ESD510-Slamsugerbanden/PublicAppendix/README.md

# PublicAppendix
Public Appendix for the 5th semester project. Consisting of test data.
