ESD510-Slamsugerbanden/PublicAppendix/Inventor/Sentry3/Motor.png

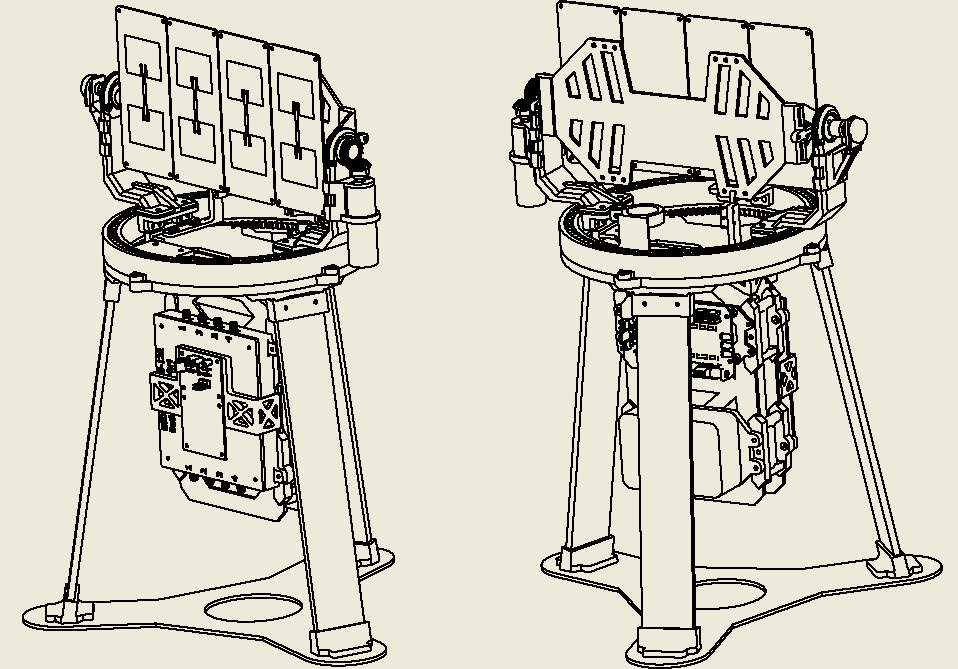
Inventor/Sentry3/Motor.png
