ESD510-Slamsugerbanden/PublicAppendix/Hardware/Komponenter/ADG904BCPZ/3D/ADG904BCPZ.stp

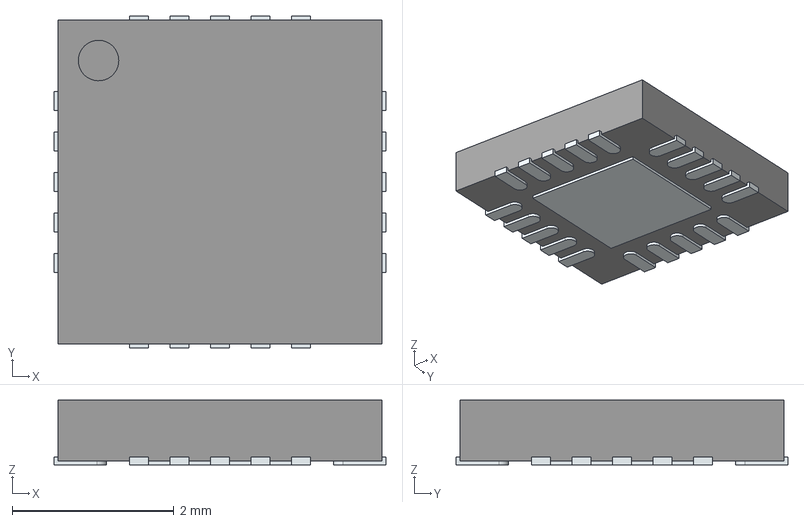
[picture p2: CAD file, 2025-12-19]
Hardware/Komponenter/ADG904BCPZ/3D/ADG904BCPZ.stp
4.10 x 4.10 x 0.8 mm
ThermalPin
PinsArrayLR
PinsArrayTB
