ESD510-Slamsugerbanden/PublicAppendix/Hardware/Komponenter/RFX2401C/3D/RFX2401C.stp

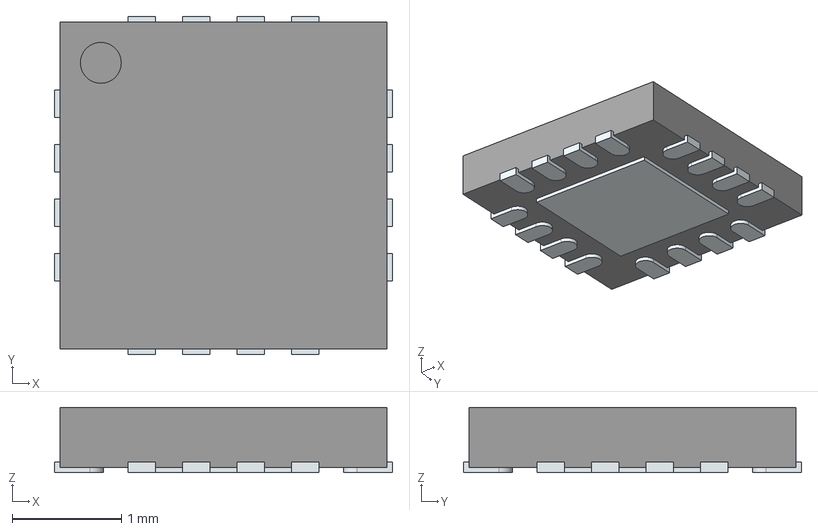
[picture p3: CAD file, 2025-12-19]
Hardware/Komponenter/RFX2401C/3D/RFX2401C.stp
3.10 x 3.10 x 0.6 mm
ThermalPin
PinsArrayLR
PinsArrayTB
