ESD510-Slamsugerbanden/PublicAppendix/Inventor/Antenna holder.stl

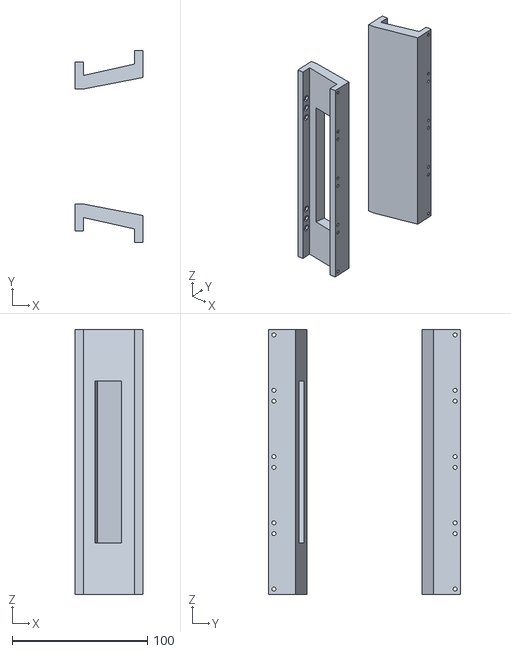
[picture p4: CAD file, 2025-12-19]
Inventor/Antenna holder.stl
50.0 x 142.0 x 196.0
