ESD510-Slamsugerbanden/PublicAppendix/Inventor/Butler_matrix/Case.stl

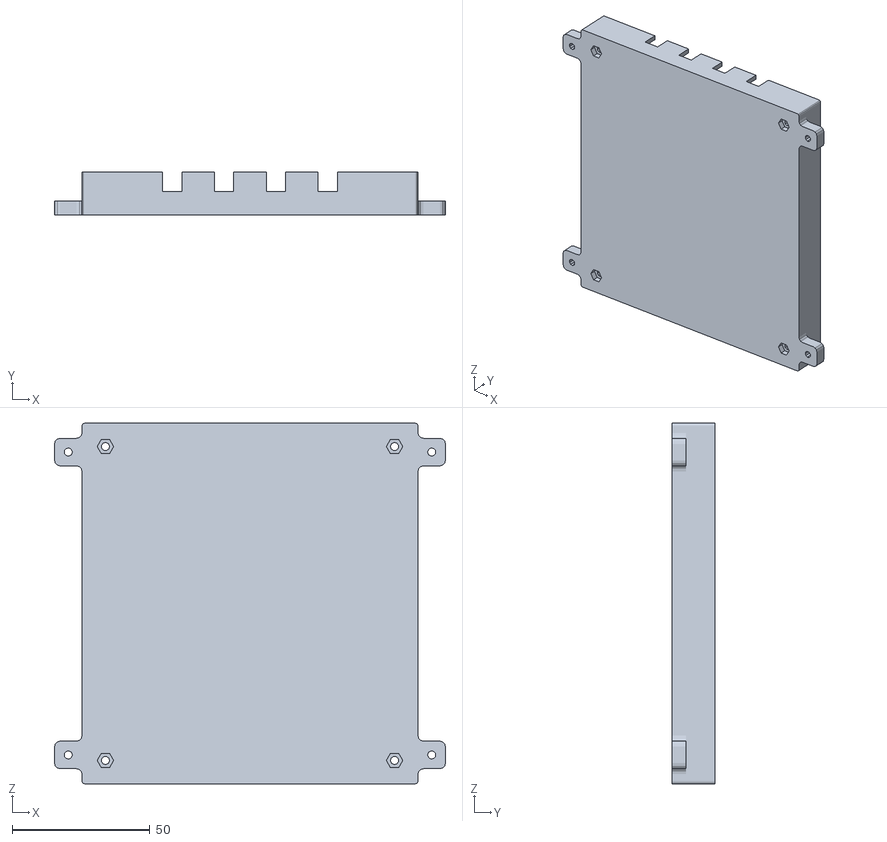
[picture p5: CAD file, 2025-12-19]
Inventor/Butler_matrix/Case.stl
142.0 x 15.5 x 131.0
