ESD510-Slamsugerbanden/PublicAppendix/Inventor/Butler_matrix/Butler_matrix.step

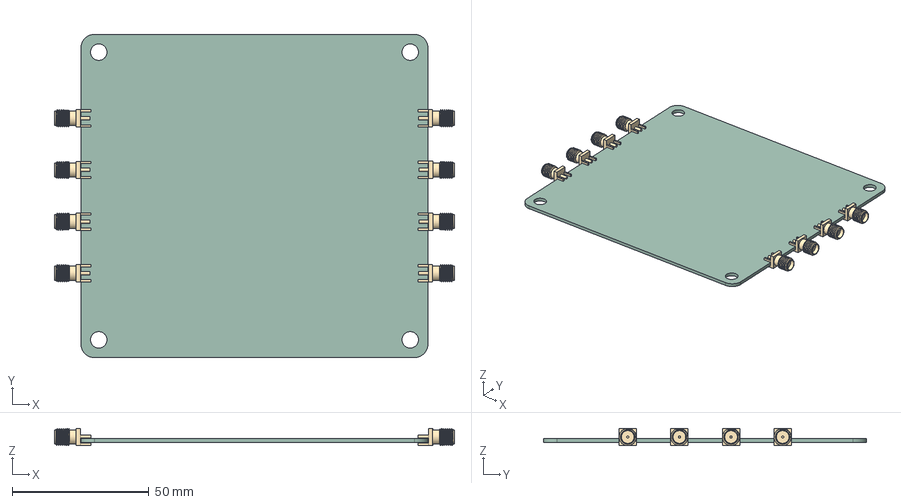
[picture p6: CAD file, 2025-12-19]
Inventor/Butler_matrix/Butler_matrix.step
146.0 x 118.0 x 6.35 mm
SMA_Samtec_SMA-J-P-H-ST-EM1_EdgeMount x 8
Butler_matrix_PCB
