ESD510-Slamsugerbanden/PublicAppendix/Inventor/Mux_adapter.step

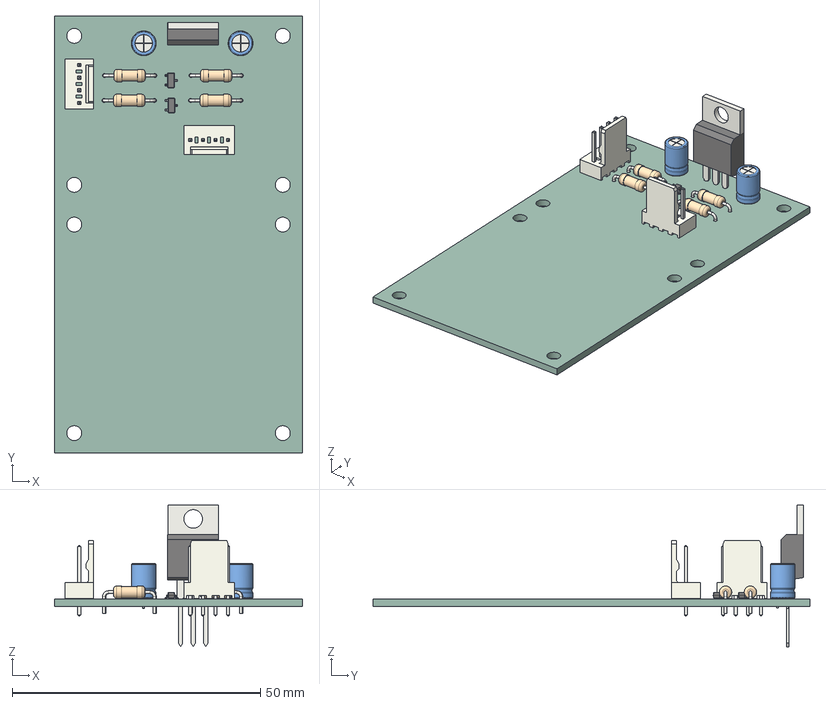
[picture p7: CAD file, 2025-12-19]
Inventor/Mux_adapter.step
50.0 x 88.0 x 28.5 mm
C_Radial_D5.0mm_H7.0mm_P2.00mm x 2
R_Axial_DIN0207_L6.3mm_D2.5mm_P10.16mm_Horizontal x 4
TO-220-3_Vertical
Molex_KK-254_AE-6410-04A_1x04_P2.54mm_Vertical x 2
SOT-23 x 2
Mux_adapter_PCB
