ESD510-Slamsugerbanden/PublicAppendix/Inventor/Sentry3/Pot_adapter.stl

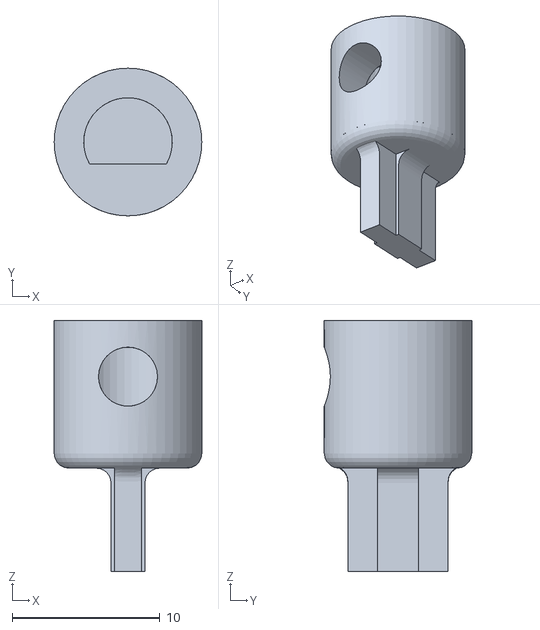
[picture p8: CAD file, 2025-12-19]
Inventor/Sentry3/Pot_adapter.stl
10.0 x 10.0 x 17.0
