ESD510-Slamsugerbanden/PublicAppendix/Inventor/Motor_controller_P5.step

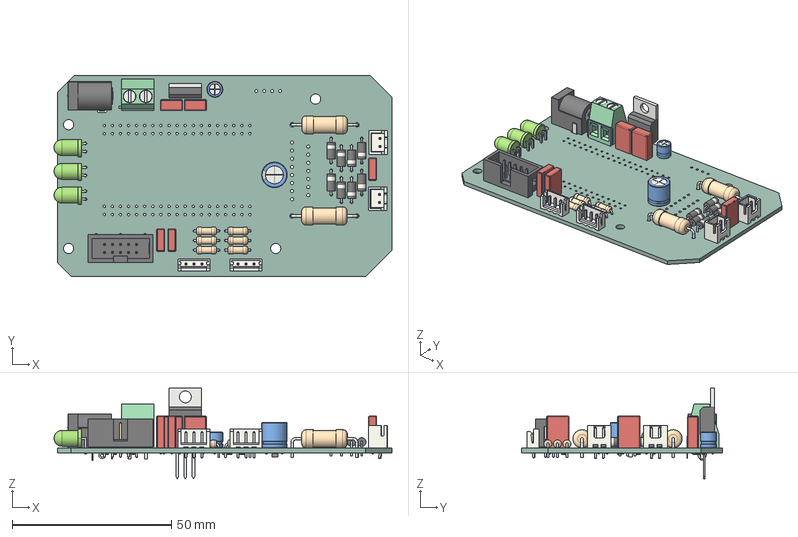
[picture p9: CAD file, 2025-12-19]
Inventor/Motor_controller_P5.step
106.1 x 63.0 x 28.5 mm
CP_Radial_D8.0mm_P5.00mm
JST_EH_B3B-EH-A_1x03_P2.50mm_Vertical x 2
C_Rect_L7.0mm_W2.5mm_P5.00mm x 3
R_Axial_DIN0614_L14.3mm_D5.7mm_P20.32mm_Horizontal x 2
R_Axial_DIN0207_L6.3mm_D2.5mm_P7.62mm_Horizontal x 6
D_A-405_P7.62mm_Horizontal x 8
CP_Radial_D5.0mm_P2.50mm
BarrelJack_Horizontal
TerminalBlock_Phoenix_MKDS-1,5-2-5.08_1x02_P5.08mm_Horizontal
IDC-Header_2x05_P2.54mm_Vertical
C_Rect_L7.0mm_W3.5mm_P5.00mm x 2
LED_D5.0mm_Horizontal_O1.27mm_Z3.0mm x 3
TO-220-3_Vertical
JST_XH_B2B-XH-A_1x02_P2.50mm_Vertical x 2
R_0603_1608Metric x 8
R_0805_2012Metric x 3
C_0805_2012Metric
Motor_controller_P5_PCB
