ESD510-Slamsugerbanden/PublicAppendix/(list of files, cad)

Other CAD files:
Inventor/Sentry3/Motor.dwg
Inventor/TestPlatform/Lasercutplade.dwg
Inventor/Backplane.dwg
Inventor/switch cover.dwg
Inventor/Cover_acryl.dwg
Inventor/Sentry3/OldVersions/Motor.0002.dwg
Hardware/Komponenter/ADG904BCPZ/Allegro/qfn50p400x400x80-21n-d.psm
Hardware/Komponenter/ADG904BCPZ/DEHDL/adg904bcpz/chips/chips.prt
Hardware/Komponenter/RFX2401C/Allegro/qfn50p300x300x60-17n-d.psm
Hardware/Komponenter/RFX2401C/DEHDL/rfx2401c/chips/chips.prt
Inventor/Antenna holder.ipt
Inventor/Backplane.ipt
Inventor/Butler_matrix/Butler_assembly.iam
Inventor/Butler_matrix/Butler_matrix/Butler_matrix.ipt
Inventor/Butler_matrix/Case.ipt
Inventor/Butler_matrix/Cover_acryl.ipt
Inventor/Butler_matrix/OldVersions/Butler_assembly.0004.iam
Inventor/Butler_matrix/OldVersions/Case.0007.ipt
Inventor/Butler_matrix/OldVersions/Cover_acryl.0005.ipt
Inventor/Mux_adapter/Mux_adapter/C_Radial_D5.0mm_H7.0mm_P2.00mm.ipt
Inventor/Mux_adapter/Mux_adapter/Molex_KK-254_AE-6410-04A_1x04_P2.54mm_Vertical.ipt
Inventor/Mux_adapter/Mux_adapter/Mux_adapter.iam
Inventor/Mux_adapter/Mux_adapter/Mux_adapter_PCB.ipt
Inventor/Mux_adapter/Mux_adapter/R_Axial_DIN0207_L6.3mm_D2.5mm_P10.16mm_Horizontal.ipt
Inventor/Mux_adapter/Mux_adapter/SOT-23.ipt
Inventor/Mux_adapter/Mux_adapter/TO-220-3_Vertical.ipt
Inventor/Mux_pcb.iam
Inventor/OldVersions/Antenna holder.0001.ipt
Inventor/OldVersions/Backplane.0003.ipt
Inventor/Sentry3/Adapter.ipt
Inventor/Sentry3/Angle_motor.ipt
Inventor/Sentry3/Balls.ipt
Inventor/Sentry3/Bearing.ipt
Inventor/Sentry3/Bund.ipt
Inventor/Sentry3/Center_lysekrone.ipt
Inventor/Sentry3/Elevation_mount.ipt
Inventor/Sentry3/Gear_2.ipt
Inventor/Sentry3/Homing_switch_holder.ipt
Inventor/Sentry3/Inner gear.ipt
Inventor/Sentry3/Krone_interface.ipt
Inventor/Sentry3/LEG.ipt
Inventor/Sentry3/Lazercut_base.ipt
Inventor/Sentry3/Lazercutlink.ipt
Inventor/Sentry3/Lock buttom.ipt
Inventor/Sentry3/Lysekrone_adapter.ipt
Inventor/Sentry3/Motor.iam
Inventor/Sentry3/Motor/Design Accelerator/Bevel Gear11.ipt
Inventor/Sentry3/Motor/Design Accelerator/Bevel Gear21.ipt
Inventor/Sentry3/Motor/Design Accelerator/Bevel Gears1.iam
Inventor/Sentry3/Motor/Design Accelerator/OldVersions/Bevel Gear11.0009.ipt
Inventor/Sentry3/Motor/Design Accelerator/OldVersions/Bevel Gear21.0004.ipt
Inventor/Sentry3/Motor/Design Accelerator/OldVersions/Bevel Gears1.0005.iam
Inventor/Sentry3/Motor/Design Accelerator/Spur Gears1.iam
Inventor/Sentry3/Motor/Design Accelerator/Worm Gear1.ipt
Inventor/Sentry3/Motor/Design Accelerator/Worm Gears1.iam
Inventor/Sentry3/Motor/Design Accelerator/Worm1.ipt
Inventor/Sentry3/Motor_driver.ipt
Inventor/Sentry3/Motor_elevation.ipt
Inventor/Sentry3/Motordriver_Adapter.ipt
Inventor/Sentry3/Mux_holder.ipt
Inventor/Sentry3/Mux_switch_holder.ipt
Inventor/Sentry3/OldVersions/Angle_motor.0001.ipt
Inventor/Sentry3/OldVersions/Bearing.0013.ipt
Inventor/Sentry3/OldVersions/Bund.0001.ipt
Inventor/Sentry3/OldVersions/Center_lysekrone.0002.ipt
Inventor/Sentry3/OldVersions/Elevation_mount.0001.ipt
Inventor/Sentry3/OldVersions/Homing_switch_holder.0001.ipt
Inventor/Sentry3/OldVersions/Inner gear.0006.ipt
Inventor/Sentry3/OldVersions/Krone_interface.0002.ipt
Inventor/Sentry3/OldVersions/LEG.0002.ipt
Inventor/Sentry3/OldVersions/Lazercut_base.0004.ipt
Inventor/Sentry3/OldVersions/Lazercutlink.0005.ipt
Inventor/Sentry3/OldVersions/Lock buttom.0005.ipt
Inventor/Sentry3/OldVersions/Motor.0057.iam
Inventor/Sentry3/OldVersions/Motor_driver.0002.ipt
Inventor/Sentry3/OldVersions/Mux_switch_holder.0003.ipt
Inventor/Sentry3/OldVersions/Outer_gear.0010.ipt
Inventor/Sentry3/OldVersions/Pi_holder.0001.ipt
Inventor/Sentry3/OldVersions/PotMeter.0004.ipt
Inventor/Sentry3/OldVersions/Pot_adapter.0004.ipt
Inventor/Sentry3/OldVersions/Pot_holder.0001.ipt
Inventor/Sentry3/OldVersions/Potmeter_elemount.0003.ipt
Inventor/Sentry3/OldVersions/RPI.0002.ipt
Inventor/Sentry3/OldVersions/Shelf1.0001.ipt
Inventor/Sentry3/OldVersions/Shelf2.0001.ipt
Inventor/Sentry3/OldVersions/Venstre arm.0004.ipt
Inventor/Sentry3/OldVersions/Venstre_bearing_lock.0002.ipt
Inventor/Sentry3/OldVersions/Venstre_roller_gear.0001.ipt
Inventor/Sentry3/OldVersions/Venstre_rotator.0004.ipt
Inventor/Sentry3/OldVersions/switch.0001.ipt
Inventor/Sentry3/Outer_gear.ipt
Inventor/Sentry3/Phased_array.ipt
Inventor/Sentry3/Pi_holder.ipt
Inventor/Sentry3/PotMeter.ipt
Inventor/Sentry3/Pot_adapter.ipt
Inventor/Sentry3/Pot_holder.ipt
Inventor/Sentry3/Potmeter_elemount.ipt
Inventor/Sentry3/RPI.ipt
Inventor/Sentry3/RPI_Motordriver_mount.ipt
Inventor/Sentry3/Shelf1.ipt
Inventor/Sentry3/Shelf2.ipt
Inventor/Sentry3/Spacer_1.ipt
Inventor/Sentry3/Spacer_1_MIR.ipt
Inventor/Sentry3/Spacer_1_MIR1.ipt
Inventor/Sentry3/Spacer_1_MIR_MIR.ipt
Inventor/Sentry3/USRPB210.ipt
Inventor/Sentry3/Venstre arm.ipt
Inventor/Sentry3/Venstre_bearing_lock.ipt
Inventor/Sentry3/Venstre_roller_gear.ipt
Inventor/Sentry3/Venstre_rotator.ipt
Inventor/Sentry3/switch.ipt
Inventor/TestPlatform/Base stand.ipt
Inventor/TestPlatform/Lasercutplade.ipt
Inventor/TestPlatform/Motor.ipt
Inventor/TestPlatform/OldVersions/Pladeholder.0001.ipt
Inventor/TestPlatform/OldVersions/TestPlatform assembly.0001.iam
Inventor/TestPlatform/Pladeholder.ipt
Inventor/TestPlatform/TestPlatform assembly.iam
Inventor/switch cover.ipt
