ESD510-Slamsugerbanden/PublicAppendix/Rotation_tracking/12rpm1_data_Testbed.txt

t;θ
0,000000E0;2,910893E1
8,333333E-2;2,752058E1
1,666667E-1;2,322311E1
2,500000E-1;2,030708E1
3,333333E-1;1,919806E1
4,166667E-1;1,711635E1
5,000000E-1;1,271856E1
5,833333E-1;9,688787E0
6,666667E-1;7,379200E0
7,500000E-1;4,555406E0
8,333333E-1;1,483055E0
9,166667E-1;-1,487868E0
1,000000E0;-4,032213E0
1,083333E0;-7,415266E0
1,166667E0;-1,074048E1
1,250000E0;-1,467208E1
1,333333E0;-1,748308E1
1,416667E0;-2,146962E1
1,500000E0;-2,474204E1
1,583333E0;-2,873174E1
1,666667E0;-3,185276E1
1,750000E0;-3,583765E1
1,833333E0;-4,115905E1
1,916667E0;-4,419117E1
2,001667E0;-4,755975E1
2,085000E0;-5,250113E1
2,168333E0;-5,617791E1
2,251667E0;-6,032596E1
2,335000E0;-6,496022E1
2,418333E0;-7,017962E1
2,501667E0;-7,436877E1
2,585000E0;-7,801823E1
2,668333E0;-8,353215E1
2,751667E0;-8,864299E1
2,835000E0;-9,315334E1
2,918333E0;-9,833256E1
3,001667E0;-1,031805E2
3,085000E0;-1,087725E2
3,168333E0;-1,145770E2
3,251667E0;-1,183604E2
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
