ESD510-Slamsugerbanden/PublicAppendix/Rotation_tracking/12rpm2_data_Testbed.txt

t;θ
6,741779E-2;3,448996E1
1,507511E-1;3,191963E1
2,340845E-1;2,588108E1
3,174178E-1;2,330618E1
4,007511E-1;2,252260E1
4,840845E-1;2,085046E1
5,674178E-1;1,764237E1
6,507511E-1;1,335912E1
7,340845E-1;1,245113E1
8,174178E-1;1,136264E1
9,007511E-1;7,080661E0
9,840845E-1;1,616067E0
1,067418E0;7,161599E-1
1,150751E0;-9,893107E-1
1,234084E0;-4,350097E0
1,317418E0;-4,384992E0
1,400751E0;-9,491630E0
1,484084E0;-1,158773E1
1,567418E0;-1,649153E1
1,650751E0;-1,958071E1
1,734084E0;-2,332916E1
1,817418E0;-2,628340E1
1,900751E0;-3,056158E1
1,984084E0;-3,391874E1
2,067418E0;-3,685167E1
2,150751E0;-4,122914E1
2,234084E0;-4,628444E1
2,317418E0;-4,927946E1
2,400751E0;-5,269960E1
2,484084E0;-5,696040E1
2,567418E0;-6,192751E1
2,650751E0;-6,745205E1
2,734084E0;-6,856801E1
2,817418E0;-7,470266E1
2,900751E0;-7,986851E1
2,984084E0;-8,406977E1
3,067418E0;-8,900538E1
3,150751E0;-9,663480E1
3,234084E0;-1,025821E2
3,319084E0;-1,096603E2
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
