ESD510-Slamsugerbanden/PublicAppendix/Rotation_tracking/12rpm3_data_Testbed.txt

t;θ
8,333333E-2;5,173387E1
1,666667E-1;5,176159E1
2,500000E-1;5,108401E1
3,333333E-1;5,174558E1
4,166667E-1;5,121835E1
5,000000E-1;5,197966E1
5,833333E-1;5,209943E1
6,666667E-1;5,073773E1
7,500000E-1;4,513609E1
8,333333E-1;4,152146E1
9,166667E-1;4,040455E1
1,000000E0;3,900523E1
1,083333E0;3,639639E1
1,166667E0;3,281559E1
1,250000E0;3,073326E1
1,333333E0;2,912043E1
1,416667E0;2,552970E1
1,500000E0;2,180141E1
1,583333E0;1,943472E1
1,666667E0;1,648728E1
1,750000E0;1,396637E1
1,833333E0;1,078430E1
1,916667E0;7,538058E0
2,000000E0;4,085617E0
2,083333E0;2,089467E0
2,166667E0;-1,617557E0
2,250000E0;-5,673022E0
2,333333E0;-8,469127E0
2,416667E0;-1,206131E1
2,500000E0;-1,553942E1
2,583333E0;-1,900698E1
2,666667E0;-2,323664E1
2,750000E0;-2,592131E1
2,833333E0;-3,083036E1
2,916667E0;-3,543635E1
3,000000E0;-3,758630E1
3,083333E0;-4,329324E1
3,166667E0;-4,775911E1
3,250000E0;-5,044033E1
3,333333E0;-5,604094E1
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
