ESD510-Slamsugerbanden/PublicAppendix/SNR_test/SNrs.csv

Sim afstand | P_r | Target
10 | -39.7 | -39.9
15 | -43.2 | -43.4
20 | -46.1 | -45.9
25 | -48.8 | -47.8
30 | -50.4 | -49.4
40 | -52.2 | -51.9
50 | -54.2 | -53.8
60 | -56 | -55.4
70 | -57 | -56.8
80 | -58.4 | -57.9
90 | -59.2 | -58.9
100 | -60.2 | -59.9
110 | -61.9 | -60.7
150 | -63.9 | -63.4
