ESD510-Slamsugerbanden/PublicAppendix/theta-estimator tests/raw/132715.csv

 | Angles | Times | RSSI
0 | 0.9027565096522394 | 1764159549.73662 | [0.01573881 0.3126059 0.29748972 0.90195881]
1 | 0.9027565096522394 | 1764159549.9634326 | [0.05703884 0.29774729 0.29507316 0.90610427]
2 | 0.8305359888800603 | 1764159550.2234085 | [0.34725778 0.32163644 0.29503398 0.83001023]
3 | 0.7583154681078812 | 1764159550.4697068 | [0.16245934 0.42923091 0.40915495 0.78864442]
4 | -0.03611026038608944 | 1764159550.7302349 | [0.34279466 0.55098412 0.53417654 0.54181523]
5 | 0.6860949473357019 | 1764159550.97249 | [0.02992278 0.30112075 0.64655855 0.70028063]
6 | -0.9749770304244185 | 1764159551.2021403 | [0.88230135 0.04894829 0.30601181 0.35426708]
7 | -0.9749770304244185 | 1764159551.4845977 | [0.95245981 0.06501437 0.15954076 0.2512771 ]
8 | 0.5416539057913436 | 1764159551.7688305 | [0.43346697 0.20331647 0.8048907 0.35059915]
9 | -0.18055130193044788 | 1764159552.1000614 | [0.31174332 0.90504685 0.20058988 0.20849459]
10 | 0.036110260386089665 | 1764159552.3207147 | [0.54887881 0.42088076 0.70937912 0.13554595]
11 | 0.036110260386089665 | 1764159552.6005723 | [0.57844516 0.40960815 0.70420431 0.04145662]
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
