ESD510-Slamsugerbanden/PublicAppendix/theta-estimator tests/raw/133930.csv

 | Angles | Times | RSSI | POS
0 | -0.03611026038608944 | 1764160321.237549 | [0.15773504 0.69474028 0.44543358 0.54225873] | 167.1
1 | -0.9749770304244185 | 1764160321.4465759 | [0.94297963 0.28096835 0.12410048 0.12823909] | 167.1
2 | -0.252771822702627 | 1764160321.6384997 | [0.21634001 0.9691874 0.07801855 0.08823771] | 167.1
3 | 0.252771822702627 | 1764160321.8447537 | [0.0838964 0.08408289 0.99270127 0.0208724 ] | 167.1
4 | 0.18055130193044788 | 1764160322.0625381 | [0.23718409 0.10141141 0.94569201 0.19780305] | 167.1
5 | 0.252771822702627 | 1764160322.2767613 | [0.03962748 0.04865802 0.99079153 0.11997582] | 167.1
6 | 0.18055130193044788 | 1764160322.4874263 | [0.07749177 0.22705589 0.94860612 0.20636636] | 167.1
7 | -0.03611026038608944 | 1764160322.7122686 | [0.23438713 0.66112939 0.67222194 0.23682962] | 167.1
8 | 0.036110260386089665 | 1764160322.9260595 | [0.16325274 0.62336063 0.74926522 0.15287805] | 167.1
9 | 0.10833078115826877 | 1764160323.1397414 | [0.12252789 0.48381496 0.85417283 0.14594099] | 167.1
10 | 0.18055130193044788 | 1764160323.3627863 | [0.10649101 0.33753932 0.92986289 0.10040852] | 167.1
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
