ESD510-Slamsugerbanden/PublicAppendix/theta-estimator tests/raw/134315.csv

 | Angles | Times | RSSI | POS
0 | 0.18055130193044788 | 1764160544.2809384 | [0.00498715 0.35492466 0.93388354 0.04318737] | 0.0
1 | 0.10833078115826877 | 1764160544.4932675 | [0.01786287 0.47546949 0.87770379 0.05697143] | 0.4
2 | 0.036110260386089665 | 1764160544.6988835 | [0.052574 0.65839062 0.7485864 0.05810477] | 0.8
3 | 0.10833078115826877 | 1764160544.9156153 | [0.04047943 0.54580626 0.8350092 0.05671494] | 1.6
4 | -0.5416539057913435 | 1764160545.1950037 | [0.59455296 0.80045965 0.05198001 0.05540042] | 2.6
5 | -0.758315468107881 | 1764160545.3801162 | [0.82817923 0.55724688 0.04206822 0.04272406] | 1.9
6 | -0.252771822702627 | 1764160545.5711746 | [0.12909313 0.98586533 0.08385486 0.06612778] | -2.7
7 | -0.18055130193044788 | 1764160545.7803397 | [0.16715723 0.95583473 0.19750062 0.1393985 ] | -7.0
8 | 0.18055130193044788 | 1764160545.9973652 | [0.01576448 0.30708764 0.9417155 0.13645727] | -9.7
9 | 0.252771822702627 | 1764160546.2185452 | [0.02434772 0.16252233 0.97886972 0.1216871 ] | -10.2
10 | 0.18055130193044788 | 1764160546.4360657 | [0.04510038 0.23841859 0.94720985 0.20956154] | -9.3
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
