ESD510-Slamsugerbanden/PublicAppendix/theta-estimator tests/raw/1764152279.9899583.csv

 | Angles | Times
0 | -0.03611026038608944 | 1764152179.0359333
1 | -0.6860949473357019 | 1764152179.2247741
2 | -0.6860949473357019 | 1764152179.415126
3 | -0.6860949473357019 | 1764152179.5679734
4 | -0.03611026038608944 | 1764152179.768595
5 | -0.03611026038608944 | 1764152179.9621515
6 | -0.03611026038608944 | 1764152180.1355064
7 | 0.036110260386089665 | 1764152180.280728
8 | 0.6860949473357019 | 1764152180.452673
9 | 0.7583154681078812 | 1764152180.6000006
10 | 0.6860949473357019 | 1764152180.7855837
11 | 0.6860949473357019 | 1764152180.96848
12 | -0.03611026038608944 | 1764152181.1570566
13 | -0.03611026038608944 | 1764152181.3430872
14 | -0.03611026038608944 | 1764152181.531729
15 | -0.03611026038608944 | 1764152181.7199748
16 | -0.03611026038608944 | 1764152181.9001334
17 | -0.03611026038608944 | 1764152182.0940087
18 | 0.036110260386089665 | 1764152182.2717443
19 | 0.10833078115826877 | 1764152182.4579499
20 | 0.10833078115826877 | 1764152182.643931
21 | 0.10833078115826877 | 1764152182.8345733
22 | 0.10833078115826877 | 1764152183.0218108
23 | 0.10833078115826877 | 1764152183.2044122
24 | 0.10833078115826877 | 1764152183.3884482
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
