ESD510-Slamsugerbanden/PublicAppendix/theta-estimator tests/raw/1764152778.2924569.csv

 | Angles | Times | RSSI
0 | 0.8779535025183596 | 1764152745.6213913 | [0.38900307 0.34461404 0.13427024 0.84373531]
1 | 0.20097730780540757 | 1764152745.8382337 | [0.25299687 0.19509749 0.94066819 0.1143368 ]
2 | -0.22213281389018735 | 1764152746.0288444 | [0.09701511 0.96297905 0.11037253 0.22600292]
3 | -0.7721759720944609 | 1764152746.1903768 | [0.71159575 0.34516106 0.32703268 0.51724748]
4 | -0.6663984416705622 | 1764152746.373368 | [0.53568984 0.54841779 0.38426027 0.51441071]
5 | -0.6029319234162229 | 1764152746.5479038 | [0.53243982 0.73190697 0.29345539 0.30774008]
6 | 0.20097730780540757 | 1764152746.736128 | [0.25510543 0.10038412 0.93694509 0.21674443]
7 | -0.010577753042389837 | 1764152746.8949778 | [0.09313047 0.70380426 0.66708462 0.22579722]
8 | 0.9625755268574785 | 1764152747.073484 | [0.05319892 0.0491108 0.30029335 0.95109511]
9 | 0.6875539477553418 | 1764152747.2488422 | [0.07097156 0.06433217 0.66711838 0.73876754]
10 | 0.5606209112466634 | 1764152747.4426441 | [0.20306337 0.17640077 0.81617432 0.51137805]
11 | 0.8356424903488002 | 1764152747.5993881 | [0.48177809 0.42742311 0.16762767 0.74639153]
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
