ESD510-Slamsugerbanden/PublicAppendix/theta-estimator tests/raw/1764152798.577408.csv

 | Angles | Times | RSSI
0 | -0.7510204660096811 | 1764152787.366369 | [0.70441305 0.392026 0.561716 0.18599197]
1 | -0.6875539477553418 | 1764152787.5396392 | [0.6254823 0.58151578 0.26689062 0.44652065]
2 | -0.5606209112466634 | 1764152787.75223 | [0.59514107 0.79952196 0.02427082 0.0773477 ]
3 | -1.0471975511965976 | 1764152787.9192932 | [0.9955279 0.05265296 0.05934671 0.05128189]
4 | -0.7298649599249014 | 1764152788.1103826 | [0.77391549 0.63181165 0.03442431 0.02615007]
5 | -0.2855993321445266 | 1764152788.2646801 | [0.09495792 0.99448194 0.03180016 0.03126373]
6 | -0.2855993321445266 | 1764152788.458191 | [0.08147224 0.99649882 0.01467501 0.01170548]
7 | -0.9414200207726988 | 1764152788.6876664 | [0.93296213 0.35409352 0.04905749 0.04234147]
8 | 0.8144869842640203 | 1764152789.0801797 | [0.41297542 0.31768233 0.30188197 0.79837116]
9 | 0.010577753042389837 | 1764152789.2564077 | [0.53181363 0.5623604 0.60864424 0.17457729]
10 | 0.7087094538401217 | 1764152789.4925764 | [0.49025586 0.4686782 0.43052651 0.59551395]
11 | -0.010577753042389837 | 1764152789.6386614 | [0.56015028 0.58603024 0.58523098 0.01746207]
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
