ESD510-Slamsugerbanden/PublicAppendix/theta-estimator tests/raw/ButlerMatrixWorking.png

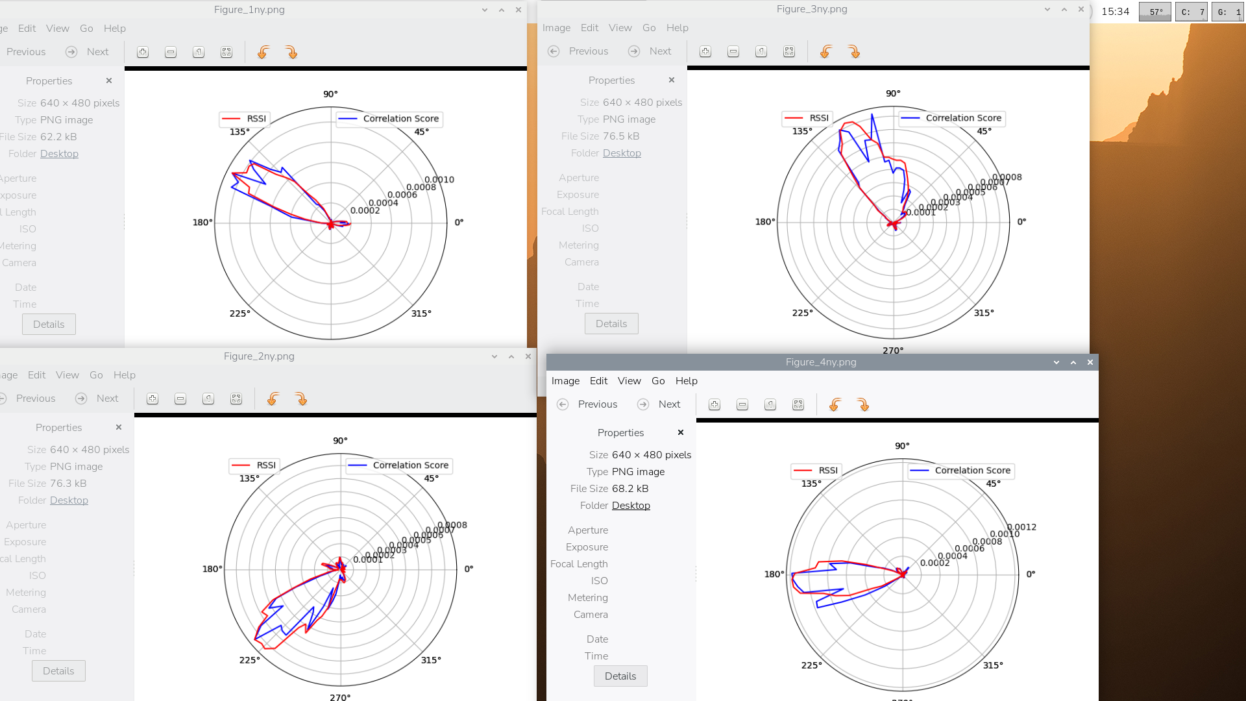
theta-estimator tests/raw/ButlerMatrixWorking.png
