ESD510-Slamsugerbanden/PublicAppendix/Inventor/Backplane.pdf

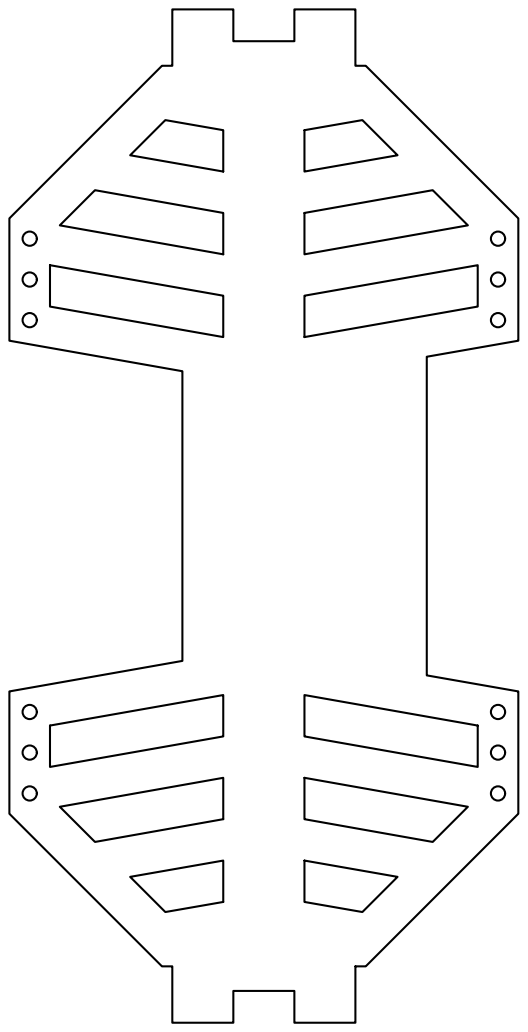
[picture p11: page 1]
