ESD510-Slamsugerbanden/PublicAppendix/Inventor/Cover_acryl.pdf

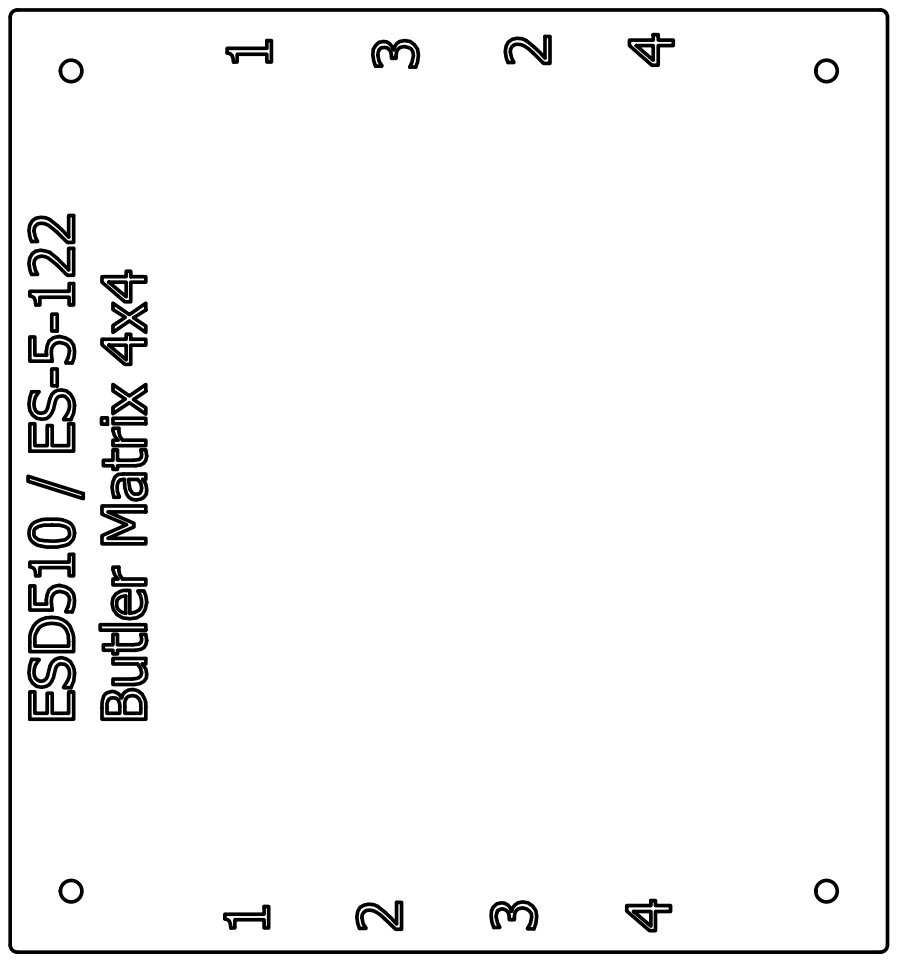
[picture p12: page 1]
