ESD510-Slamsugerbanden/PublicAppendix/Inventor/switch cover.pdf

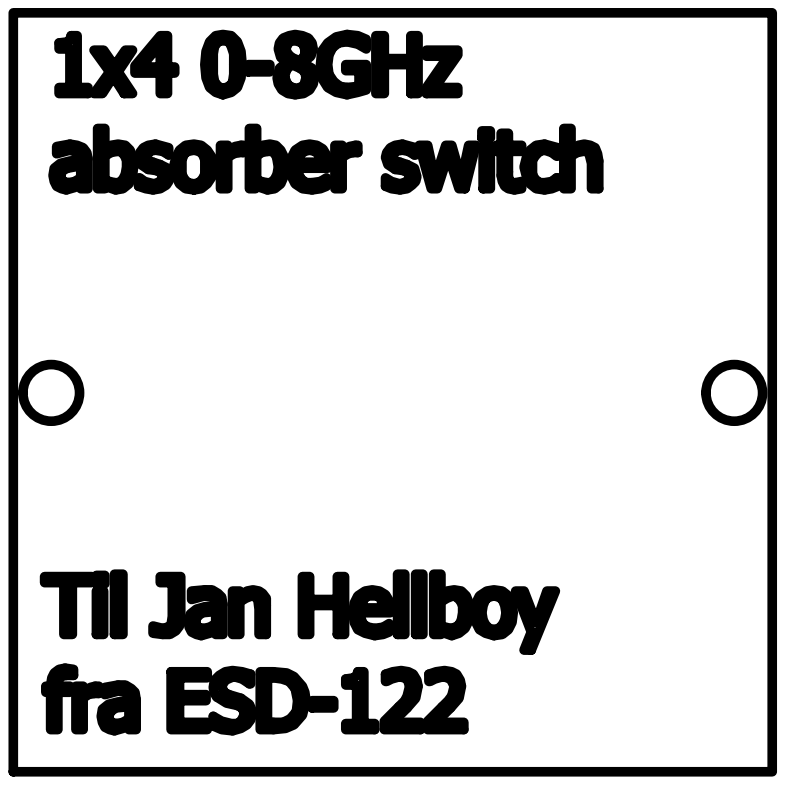
[picture p13: page 1]
