ESD510-Slamsugerbanden/PublicAppendix/Inventor/Sentry3/BacksideMotor.pdf

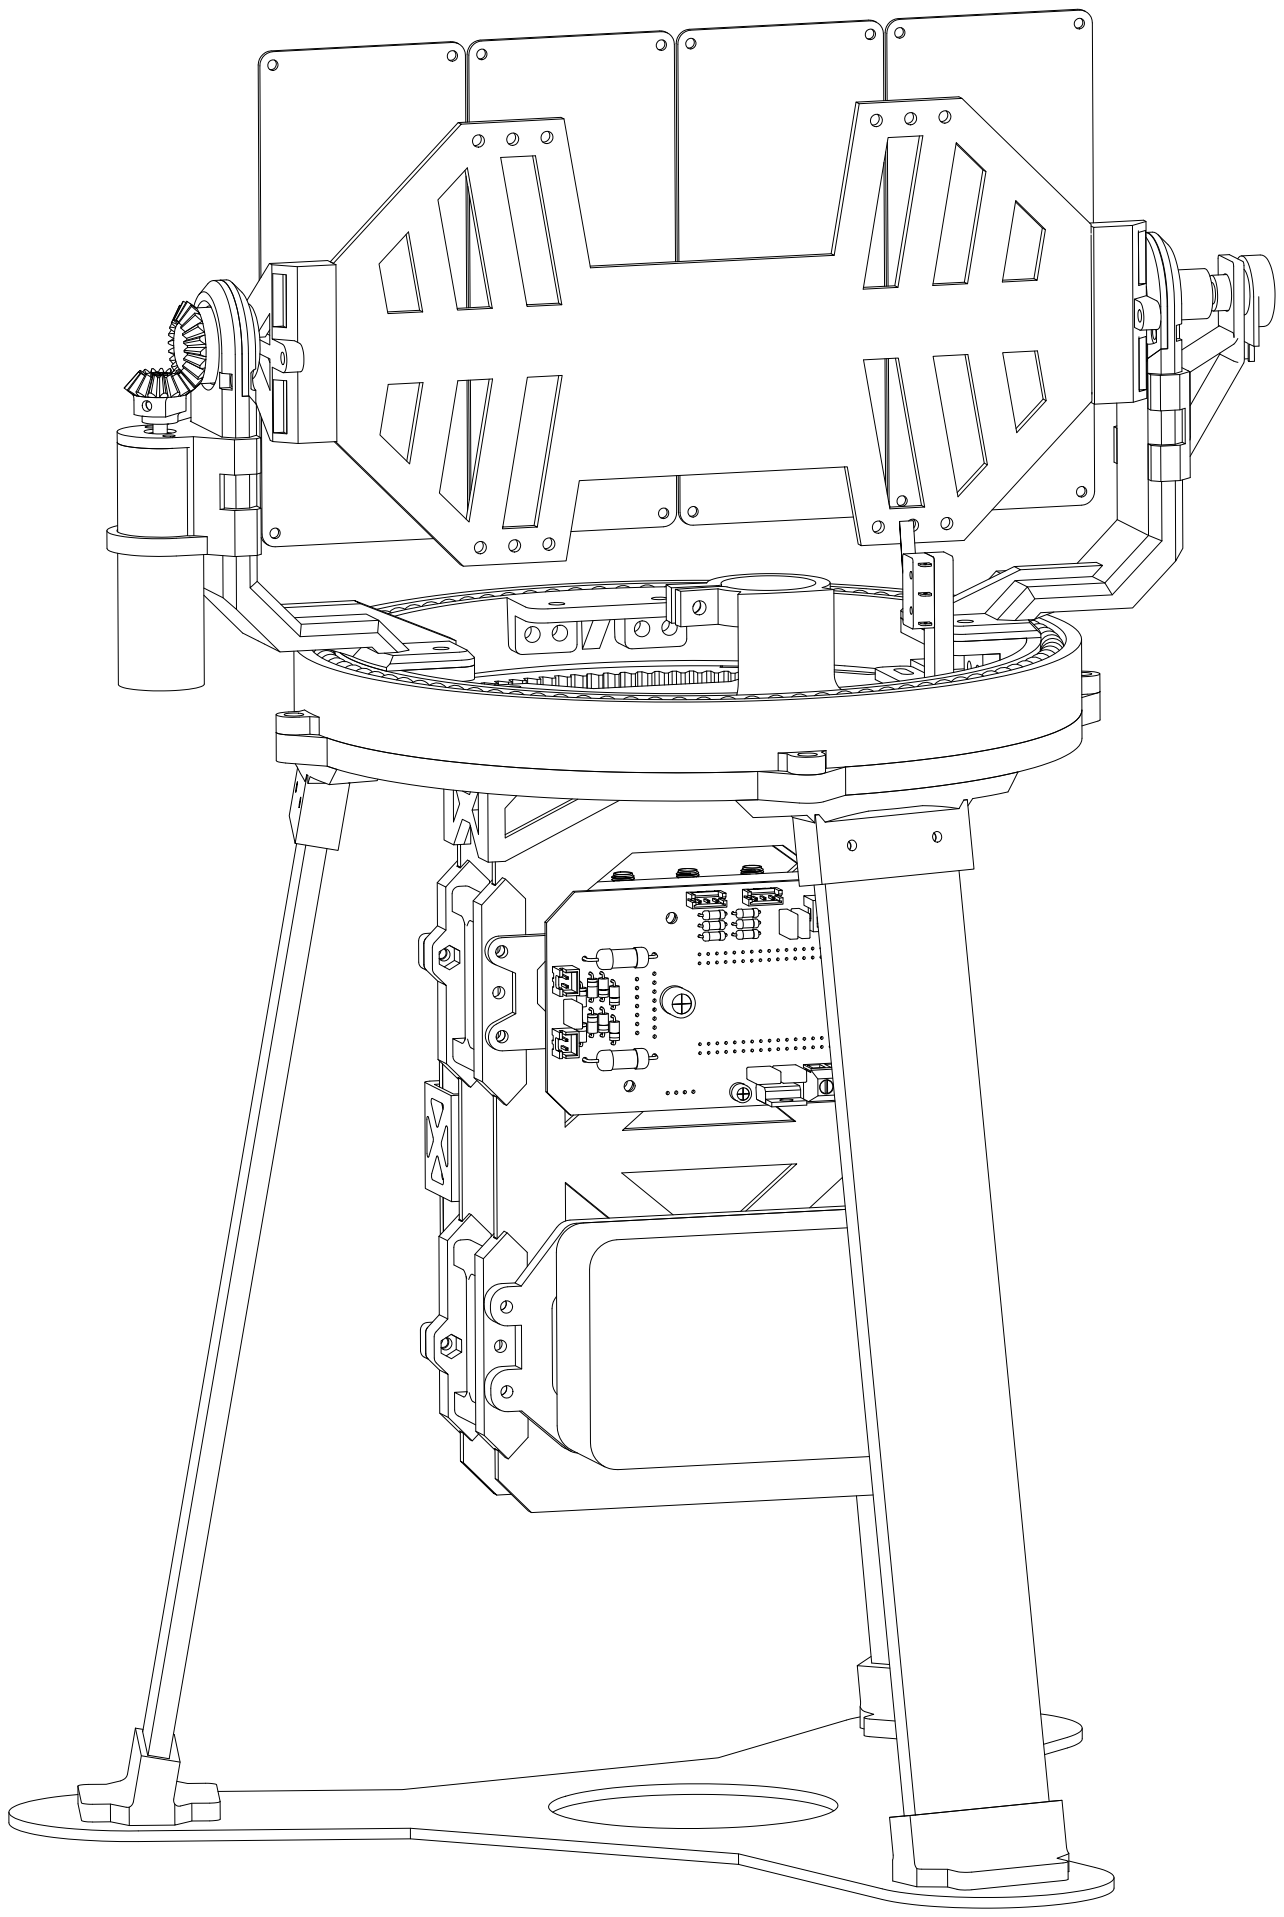
[picture p14: page 1]
