ESD510-Slamsugerbanden/PublicAppendix/Inventor/Sentry3/Motor.pdf

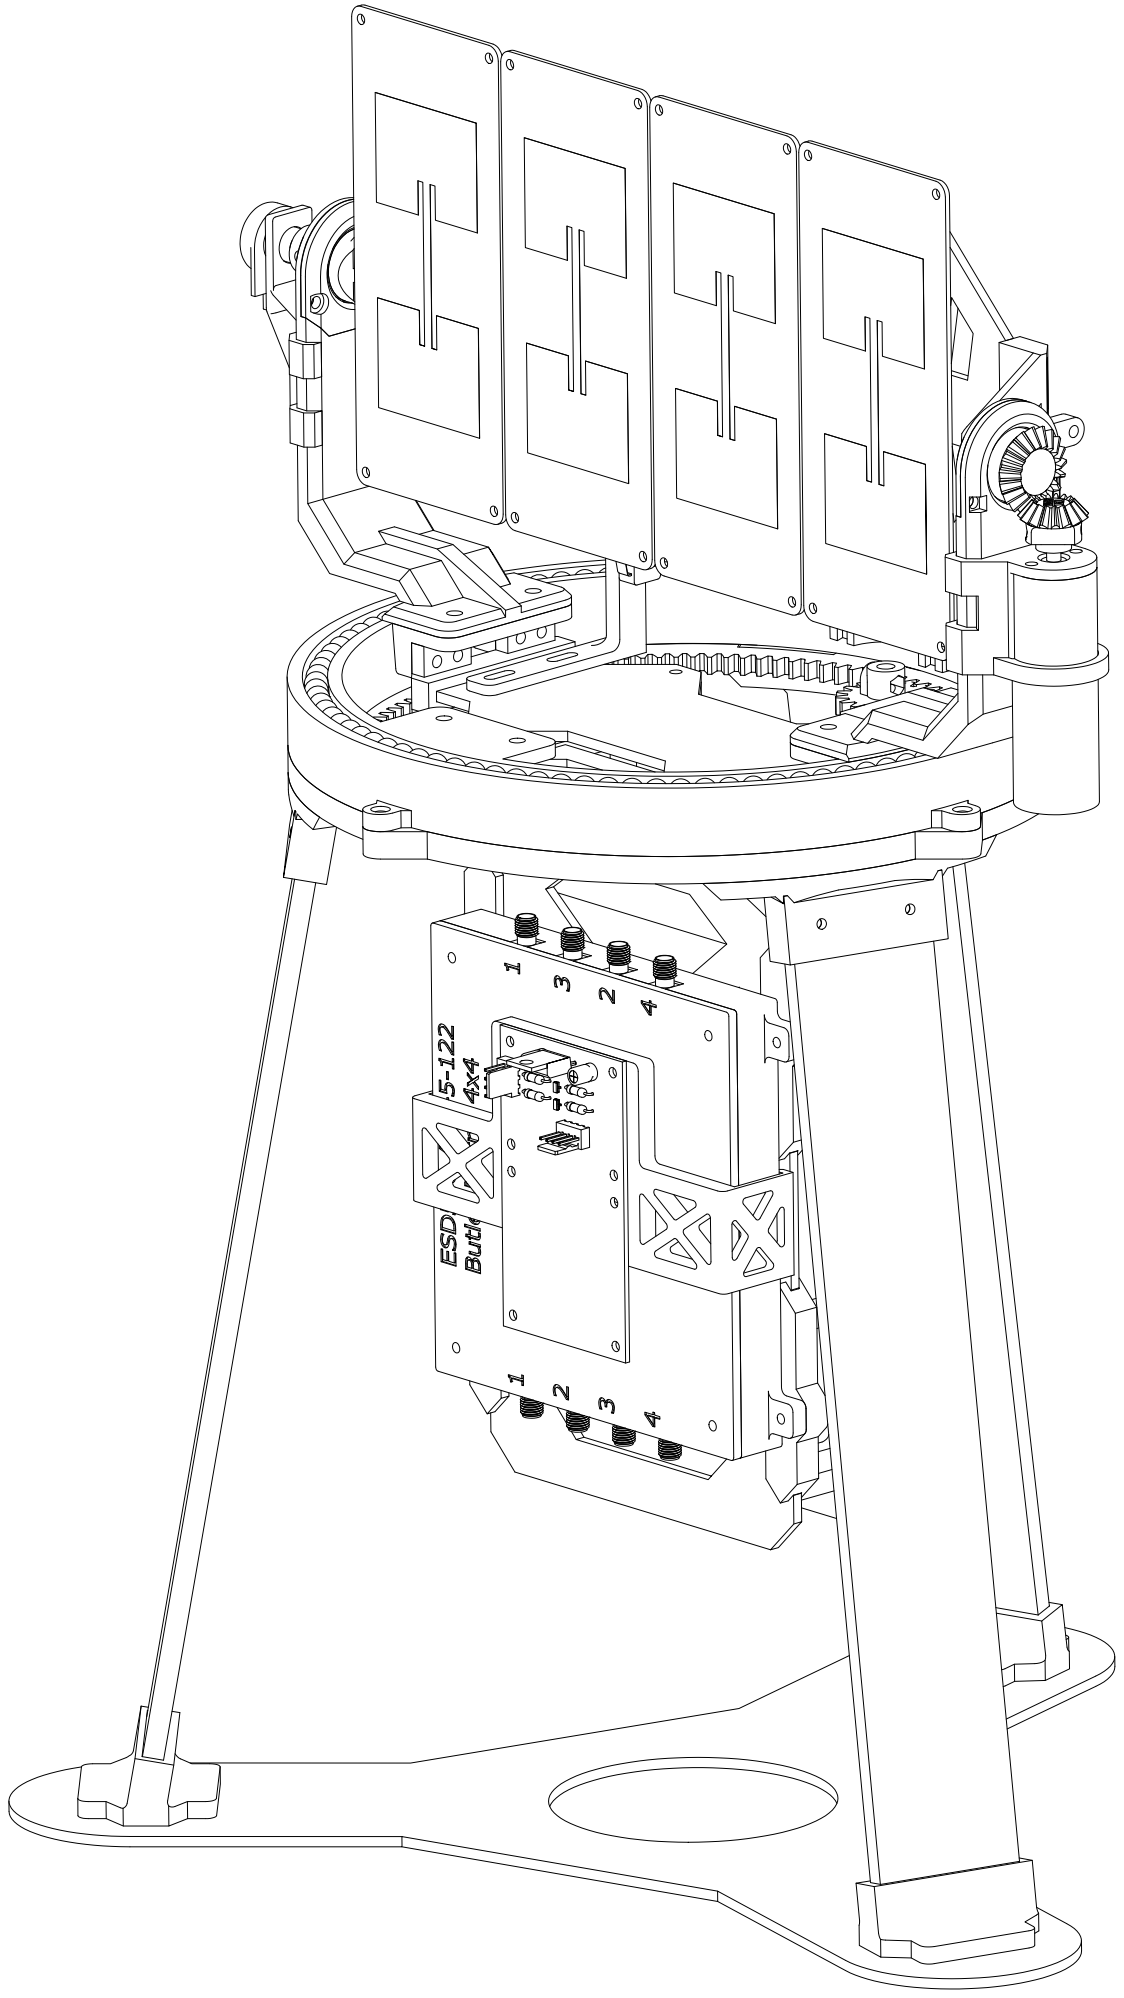
[picture p15: page 1]
