ESD510-Slamsugerbanden/PublicAppendix/(list of files, drawings)

Other design files:
Hardware/Komponenter/ADG904BCPZ/Altium/ADG904BCPZ.SchLib
Hardware/Komponenter/ADG904BCPZ/Altium/QFN50P400X400X80-21N-D.PcbLib
Hardware/Komponenter/RFX2401C/Altium/QFN50P300X300X60-17N-D.PcbLib
Hardware/Komponenter/RFX2401C/Altium/RFX2401C.SchLib
