ESD510-Slamsugerbanden/PublicAppendix/Hardware/Switch/4_1_Switch.kicad_pcb

## KiCad design Hardware/Switch/4_1_Switch.kicad_pcb (2025-12-19)

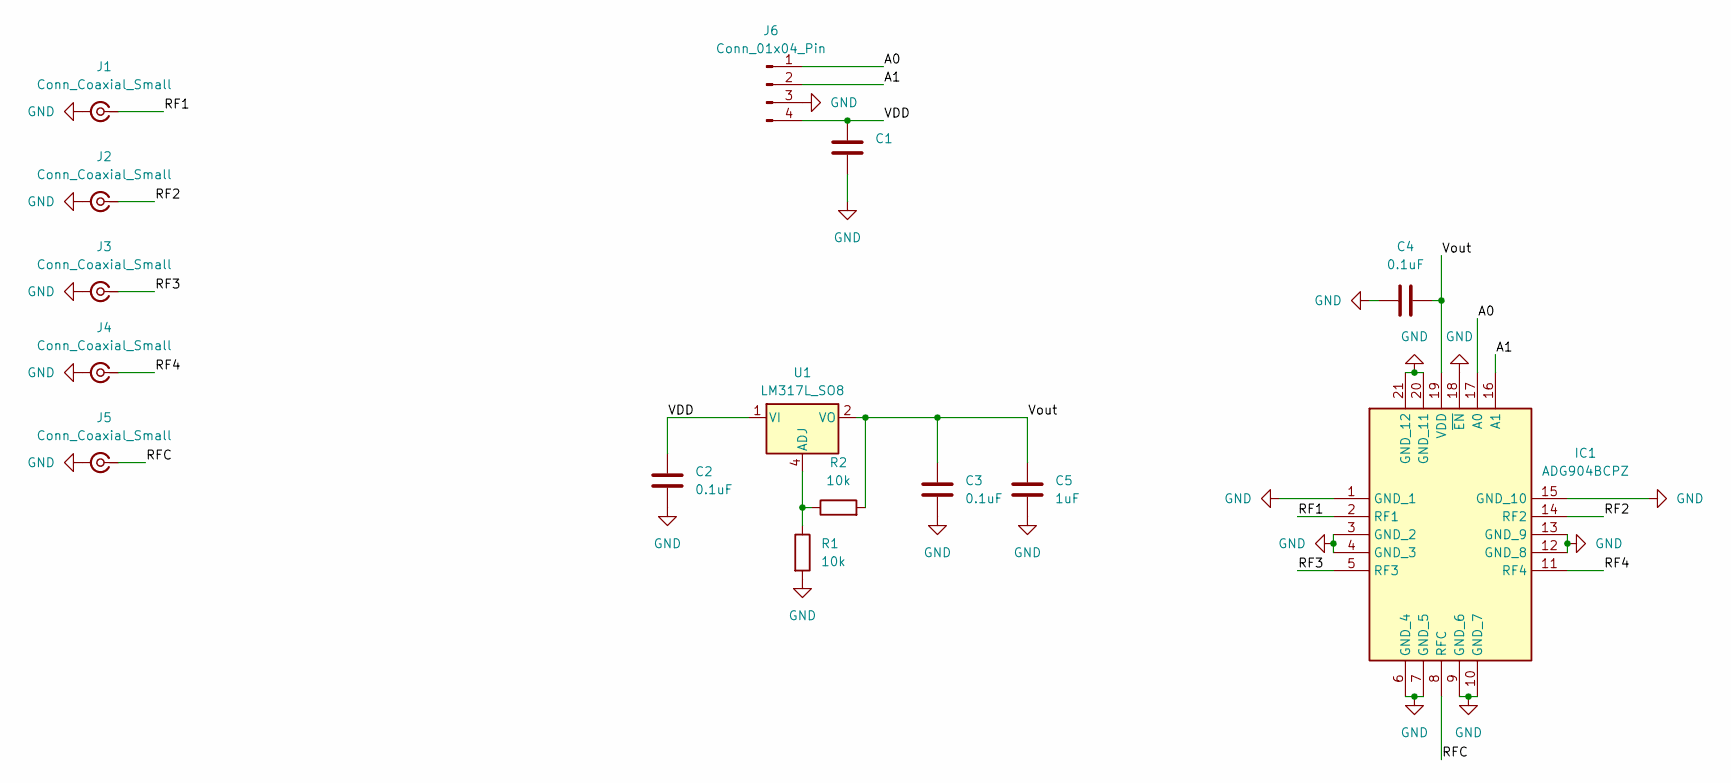
[picture p16: schematic 4_1_Switch.kicad_sch]

Parts:
C1: C_0805_2012Metric_Pad1.18x1.45mm_HandSolder
C2, C3, C4: 0.1uF; C_0805_2012Metric_Pad1.18x1.45mm_HandSolder
C5: 1uF; C_0805_2012Metric_Pad1.18x1.45mm_HandSolder
IC1: ADG904BCPZ; Manufacturer_Part_Number ADG904BCPZ; Mouser Part Number 584-ADG904BCPZ
J1, J2, J3, J4, J5: Conn_Coaxial_Small; SMA_Samtec_SMA-J-P-H-ST-EM1_EdgeMount
J6: Conn_01x04_Pin; JST_XH_B4B-XH-AM_1x04_P2.50mm_Vertical
R1, R2: 10k; R_0805_2012Metric_Pad1.20x1.40mm_HandSolder
U1: LM317L_SO8; SOIC-8_3.9x4.9mm_P1.27mm

Connections:
/A0: IC1.17 (A0), J6.1
/A1: IC1.16 (A1), J6.2
/RF1: IC1.2 (RF1), J1.1 (In)
/RF2: IC1.14 (RF2), J2.1 (In)
/RF3: IC1.5 (RF3), J3.1 (In)
/RF4: IC1.11 (RF4), J4.1 (In)
/RFC: IC1.8 (RFC), J5.1 (In)
/VDD: C1.1, C2.1, J6.4, U1.1 (VI)
/Vout: C3.1, C4.2, C5.1, IC1.19 (VDD), R2.2, U1.2 (VO), U1.3 (VO), U1.6 (VO), U1.7 (VO)
GND: C1.2, C2.2, C3.2, C4.1, C5.2, IC1.1 (GND_1), IC1.3 (GND_2), IC1.4 (GND_3), IC1.6 (GND_4), IC1.7 (GND_5), IC1.9 (GND_6), IC1.10 (GND_7), IC1.12 (GND_8), IC1.13 (GND_9), IC1.15 (GND_10), IC1.18 (~EN), IC1.20 (GND_11), IC1.21 (GND_12), J1.2 (Ext), J2.2 (Ext), J3.2 (Ext), J4.2 (Ext), J5.2 (Ext), J6.3, R1.2
unnamed: R1.1, R2.1, U1.4 (ADJ)

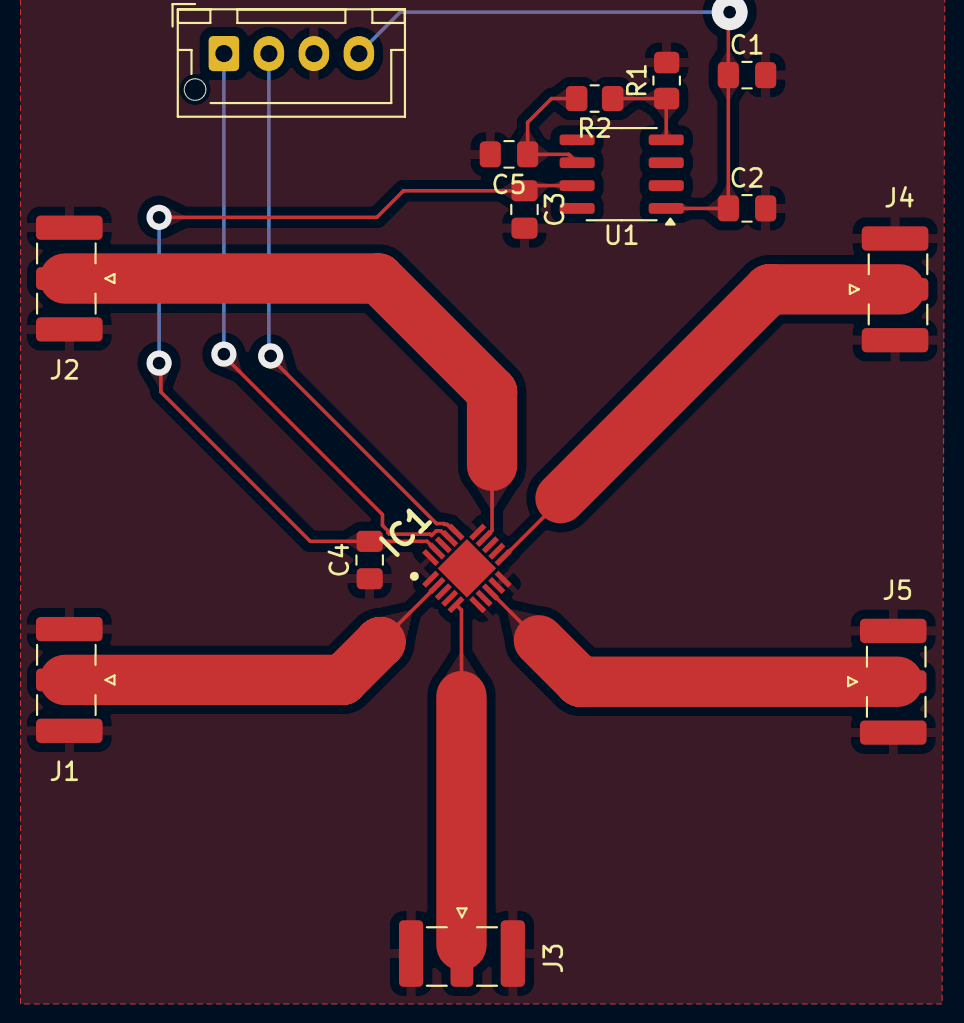
[picture p17: board 4_1_Switch.kicad_pcb from above]

Board: 2 copper layers, 15 parts (0 on the bottom side), 11 nets.
