ESD510-Slamsugerbanden/PublicAppendix/Hardware/Butler_Matrix/Butler_matrix/Butler_matrix.kicad_pcb

## KiCad design Hardware/Butler_Matrix/Butler_matrix/Butler_matrix.kicad_pcb (2025-12-19)

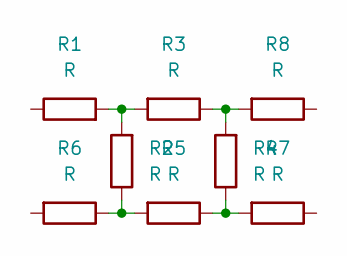
[picture p18: schematic Butler_matrix.kicad_sch]

Parts:
R1, R2, R4, R6, R7, R8: R; zo_245GHz
R3, R5: R; Hybrid_part

Connections:
unnamed: R1.2, R2.2, R3.2
unnamed: R2.1, R5.2, R6.1
unnamed: R3.1, R4.2, R8.2
unnamed: R4.1, R5.1, R7.2

Board: 2 copper layers, 8 parts (0 on the bottom side), 4 nets, no tracks yet.
