ESD510-Slamsugerbanden/PublicAppendix/Platform controller/Motor_controller_P5/Motor_controller_P5.kicad_pcb

## KiCad design Platform controller/Motor_controller_P5/Motor_controller_P5.kicad_pcb (2025-12-18)

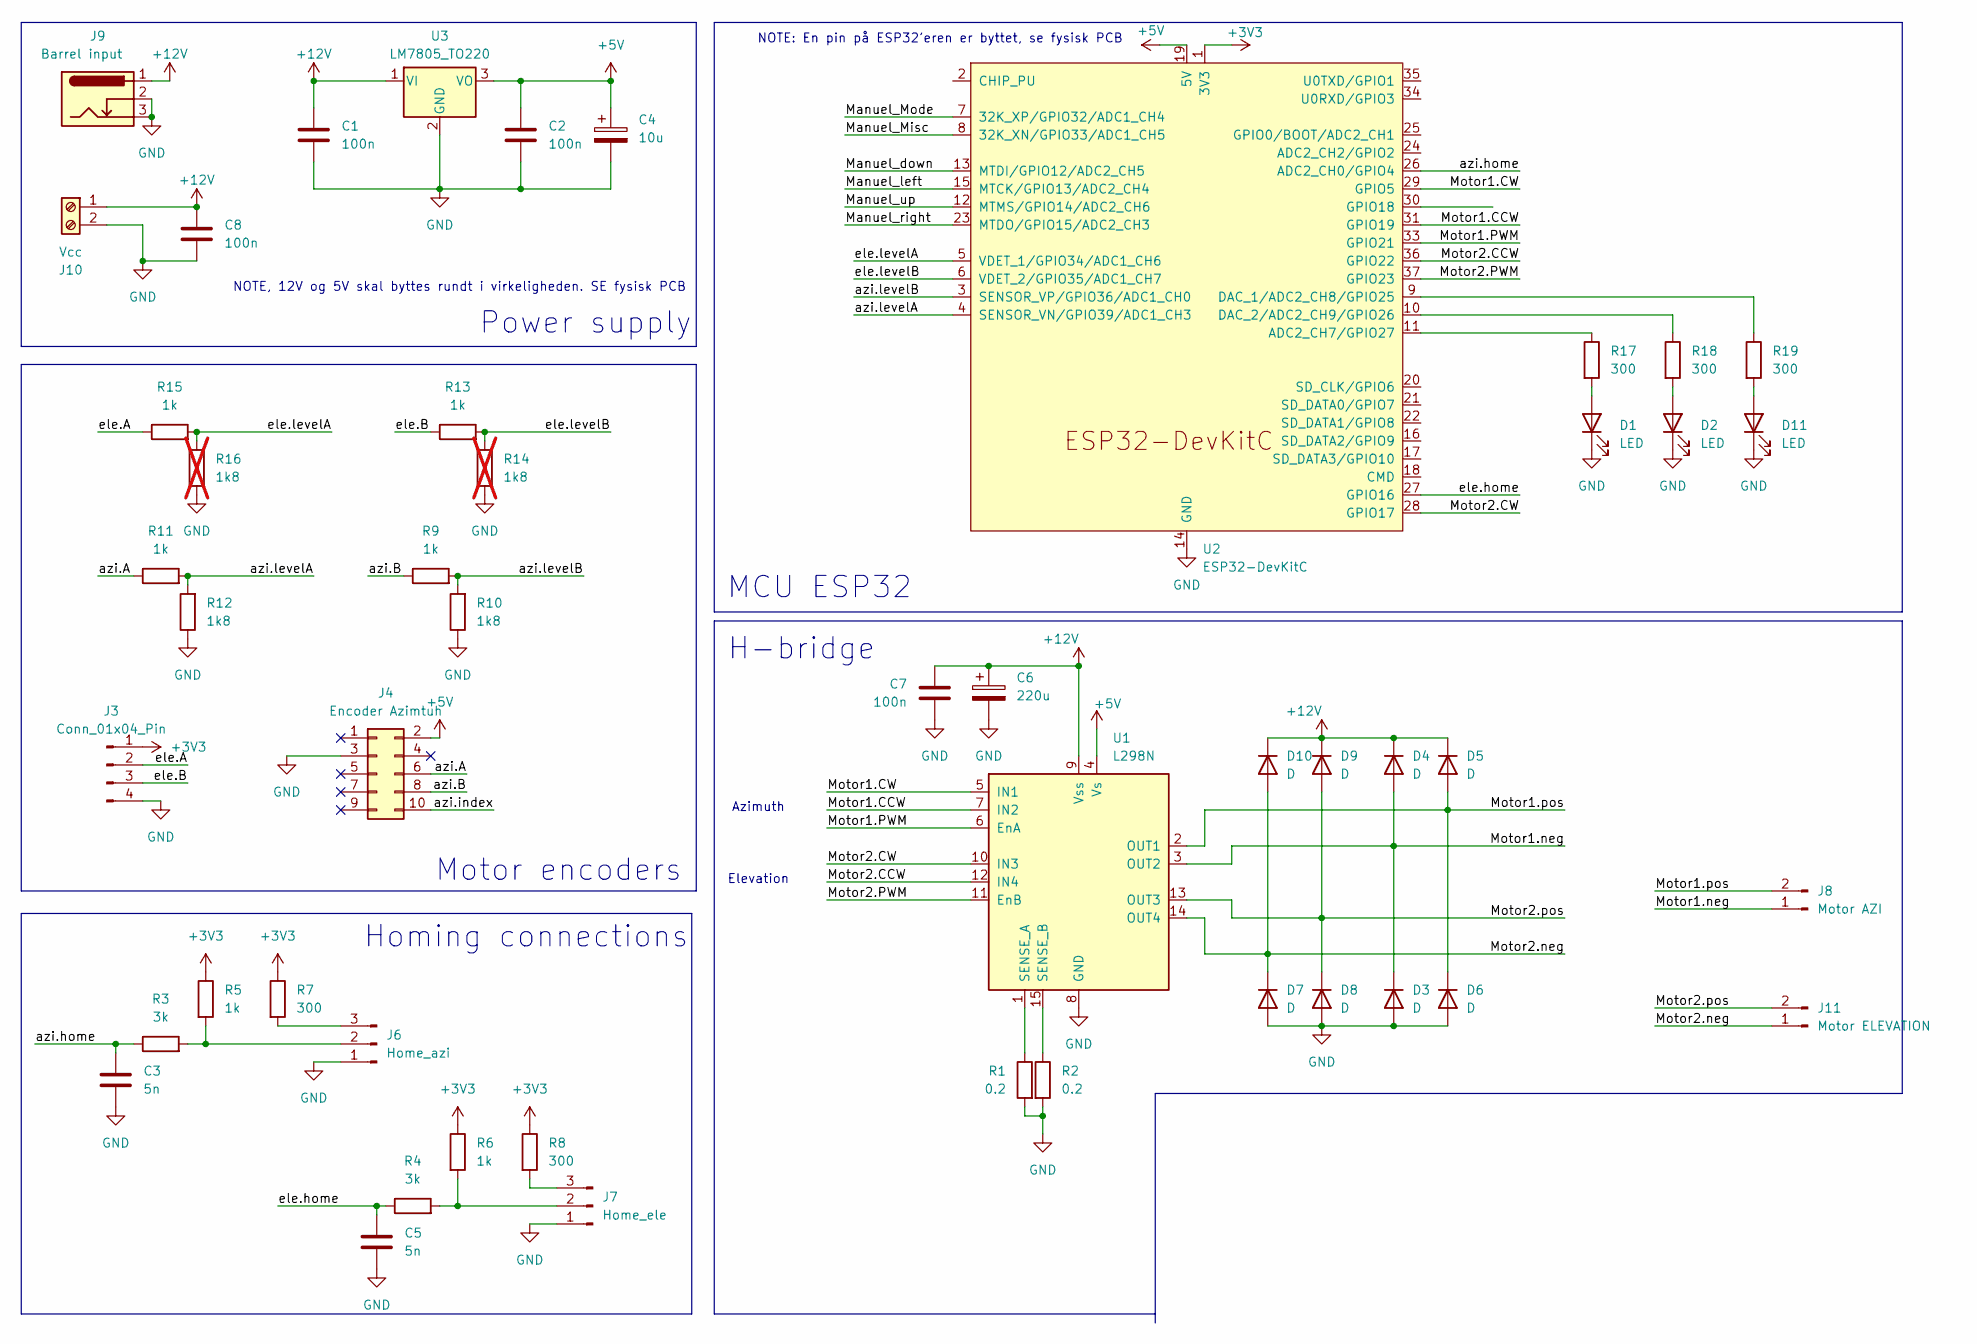
[picture p19: schematic Motor_controller_P5.kicad_sch]

Parts:
C1, C2: 100n; C_Rect_L7.0mm_W3.5mm_P5.00mm
C3, C5: 5n; C_Rect_L7.0mm_W2.5mm_P5.00mm
C4: 10u; CP_Radial_D5.0mm_P2.50mm
C6: 220u; CP_Radial_D8.0mm_P5.00mm
C7: 100n; C_0805_2012Metric_Pad1.18x1.45mm_HandSolder
C8: 100n; C_Rect_L7.0mm_W2.5mm_P5.00mm
D1, D2, D11: LED; LED_D5.0mm_Horizontal_O1.27mm_Z3.0mm
D3, D4, D5, D6, D7, D8, D9, D10: D; D_A-405_P7.62mm_Horizontal
J3: Conn_01x04_Pin; JST_XH_B4B-XH-AM_1x04_P2.50mm_Vertical
J4: Encoder Azimtuh; IDC-Header_2x05_P2.54mm_Vertical
J6: Home_azi; JST_EH_B3B-EH-A_1x03_P2.50mm_Vertical
J7: Home_ele; JST_EH_B3B-EH-A_1x03_P2.50mm_Vertical
J8: Motor AZI; JST_XH_B2B-XH-A_1x02_P2.50mm_Vertical
J9: Barrel input; BarrelJack_Horizontal
J10: Vcc; TerminalBlock_Phoenix_MKDS-1,5-2-5.08_1x02_P5.08mm_Horizont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
J11: Motor ELEVATION; JST_XH_B2B-XH-A_1x02_P2.50mm_Vertical
R1, R2: 0.2; R_Axial_DIN0614_L14.3mm_D5.7mm_P20.32mm_Horizontal
R3, R4: 3k; R_Axial_DIN0207_L6.3mm_D2.5mm_P7.62mm_Horizontal
R5, R6: 1k; R_Axial_DIN0207_L6.3mm_D2.5mm_P7.62mm_Horizontal
R7, R8: 300; R_Axial_DIN0207_L6.3mm_D2.5mm_P7.62mm_Horizontal
R9, R11, R13, R15: 1k; R_0603_1608Metric
R10, R12: 1k8; R_0603_1608Metric
R14, R16: 1k8; R_0603_1608Metric; not fitted
R17, R18, R19: 300; R_0805_2012Metric_Pad1.20x1.40mm_HandSolder
U1: L298N; TO-220-15_P2.54x5.08mm_StaggerOdd_Lead4.58mm_Vertical
U2: ESP32-DevKitC
U3: LM7805_TO220; TO-220-3_Vertical

Connections:
+3V3: J3.1, R5.1, R6.1, R7.1, R8.1, U2.1 (3V3)
+5V: C2.1, C4.1, J4.2, U1.4 (Vs), U2.19 (5V), U3.3 (VO)
+12V: C1.1, C6.1, C7.1, C8.1, D4.1 (K), D5.1 (K), D9.1 (K), D10.1 (K), J9.1, J10.1, U1.9 (Vss), U3.1 (VI)
/Manuel_Misc: U2.8 (32K_XN/GPIO33/ADC1_CH5)
/Manuel_Mode: U2.7 (32K_XP/GPIO32/ADC1_CH4)
/Manuel_down: U2.13 (MTDI/GPIO12/ADC2_CH5)
/Manuel_left: U2.15 (MTCK/GPIO13/ADC2_CH4)
/Manuel_right: U2.23 (MTDO/GPIO15/ADC2_CH3)
/Manuel_up: U2.12 (MTMS/GPIO14/ADC2_CH6)
/Motor1.CCW: U1.7 (IN2), U2.31 (GPIO19)
/Motor1.CW: U1.5 (IN1), U2.29 (GPIO5)
/Motor1.PWM: U1.6 (EnA), U2.33 (GPIO21)
/Motor1.neg: D3.1 (K), D4.2 (A), J8.1, U1.3 (OUT2)
/Motor1.pos: D5.2 (A), D6.1 (K), J8.2, U1.2 (OUT1)
/Motor2.CCW: U1.12 (IN4), U2.36 (GPIO22)
/Motor2.CW: U1.10 (IN3), U2.28 (GPIO17)
/Motor2.PWM: U1.11 (EnB), U2.37 (GPIO23)
/Motor2.neg: D7.1 (K), D10.2 (A), J11.1, U1.14 (OUT4)
/Motor2.pos: D8.1 (K), D9.2 (A), J11.2, U1.13 (OUT3)
/azi.A: J4.6, R11.1
/azi.B: J4.8, R9.1
/azi.home: C3.1, R3.1, U2.26 (ADC2_CH0/GPIO4)
/azi.index: J4.10
/azi.levelA: R11.2, R12.2, U2.4 (SENSOR_VN/GPIO39/ADC1_CH3)
/azi.levelB: R9.2, R10.2, U2.3 (SENSOR_VP/GPIO36/ADC1_CH0)
/ele.A: J3.2, R15.1
/ele.B: J3.3, R13.1
/ele.home: C5.1, R4.1, U2.27 (GPIO16)
/ele.levelA: R15.2, R16.2, U2.5 (VDET_1/GPIO34/ADC1_CH6)
/ele.levelB: R13.2, R14.2, U2.6 (VDET_2/GPIO35/ADC1_CH7)
GND: C1.2, C2.2, C3.2, C4.2, C5.2, C6.2, C7.2, C8.2, D1.1 (K), D2.1 (K), D3.2 (A), D6.2 (A), D7.2 (A), D8.2 (A), D11.1 (K), J3.4, J4.3, J6.1, J7.1, J9.2, J9.3, J10.2, R1.2, R2.2, R10.1, R12.1, R14.1, R16.1, U1.8 (GND), U2.14 (GND), U2.32 (GND), U2.38 (GND), U3.2 (GND)
unnamed: D1.2 (A), R17.2
unnamed: D2.2 (A), R18.2
unnamed: D11.2 (A), R19.2
unnamed: J6.2, R3.2, R5.2
unnamed: J6.3, R7.2
unnamed: J7.2, R4.2, R6.2
unnamed: J7.3, R8.2
unnamed: R1.1, U1.1 (SENSE_A)
unnamed: R2.1, U1.15 (SENSE_B)
unnamed: R17.1, U2.11 (ADC2_CH7/GPIO27)
unnamed: R19.1, U2.9 (DAC_1/ADC2_CH8/GPIO25)
unnamed: R18.1, U2.10 (DAC_2/ADC2_CH9/GPIO26)

Notes on the sheet:
Motor encoders
Homing connections
Power supply
MCU ESP32
NOTE, 12V og 5V skal byttes rundt i virkeligheden. SE fysisk PCB
H-bridge
NOTE: En pin på ESP32'eren er byttet, se fysisk PCB
Azimuth
Elevation

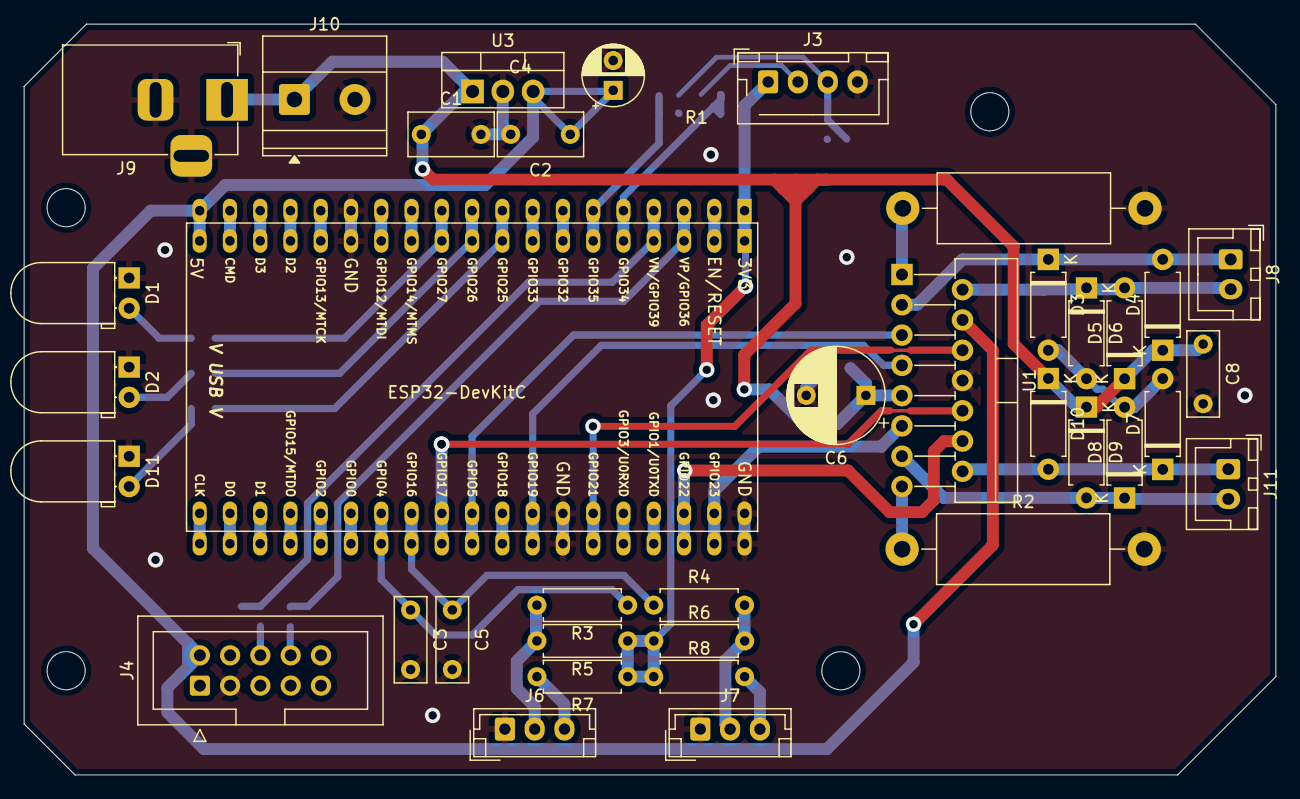
[picture p20: board Motor_controller_P5.kicad_pcb from above]

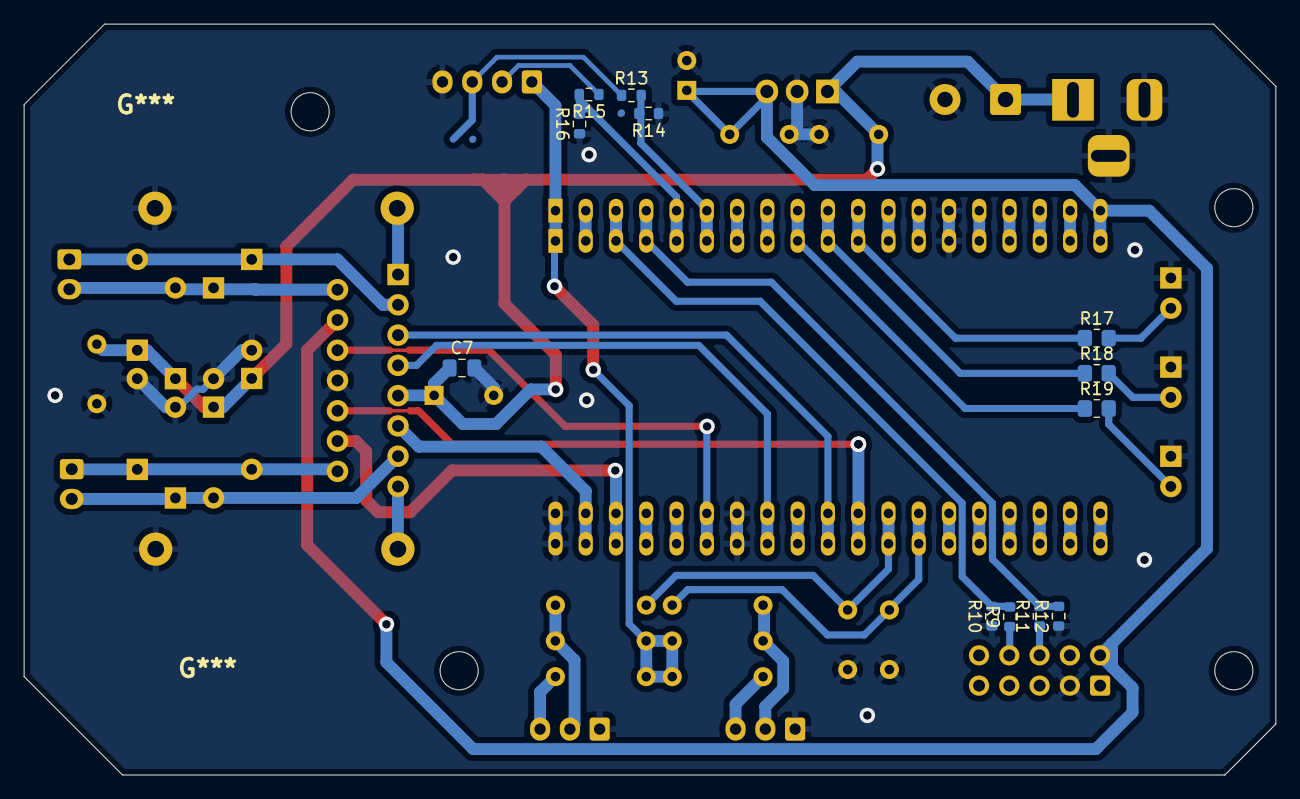
[picture p21: board Motor_controller_P5.kicad_pcb from below]

Board: 2 copper layers, 105.0 x 63.0 mm, 49 parts (12 on the bottom side), 36 nets.
