ESD510-Slamsugerbanden/PublicAppendix/(commit log)

2025-12-17 Added Platform CTRL files
    Files, including measurements, matlab script and simulink simulation for PID with saturation anti-windup mm..
2025-12-18 Added SNR test
    [SNrs.csv]
2025-12-18 Added initial search data and python scripts
    [Pos1_16vinkel.csv, Pos2_16vinkel.csv, Pos3_16vinkel.csv, Pos4_16vinkel.csv, Pos5_16vinkel.csv, Pos6_16vinkel.csv]
2025-12-18 More files and functional code
    [132715.csv, 133930.csv, 134315.csv, 1764152279.9899583.csv, 1764152778.2924569.csv, 1764152798.577408.csv, 1764152898.619791.csv, 1764152930.995042.csv]
2025-12-19 Stationary accuracy tests
    [10metertestv2.csv, 20metertestv2.csv, 30metertestv2.csv, 40metertestv2.csv, 50metertesv2.csv]
2025-12-19 Added Hardware files, mainly Kicad
    [4_1_Switch.kicad_pcb, 4_1_Switch.kicad_sch, ADG904BCPZ.SchLib, ADG904BCPZ.stp, Butler_matrix.kicad_pcb, Butler_matrix.kicad_sch, EDI2CAP.CFG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]
2025-12-19 Added inventor files for the entire platform mm.
    [Adapter.ipt, Angle_motor.0001.ipt, Angle_motor.ipt, Antenna holder.0001.ipt, Antenna holder.ipt, Antenna holder.stl, Backplane.0003.ipt, Backplane.dwg]
